Llamero/MHz_LED_Modulator/2.png

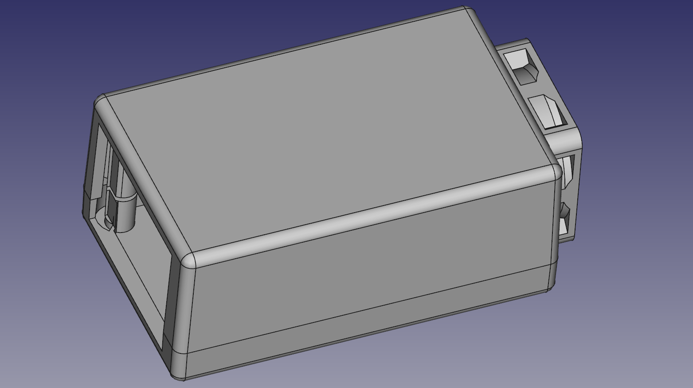
2.png
