Llamero/MHz_LED_Modulator/1.PNG

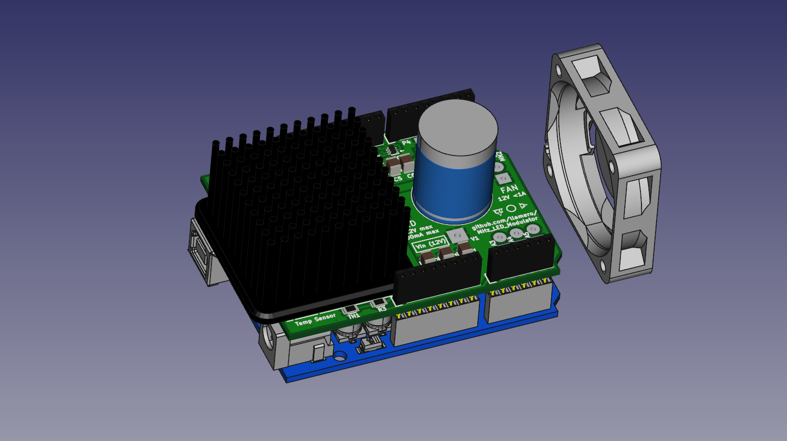
1.PNG
