Llamero/MHz_LED_Modulator/3.png

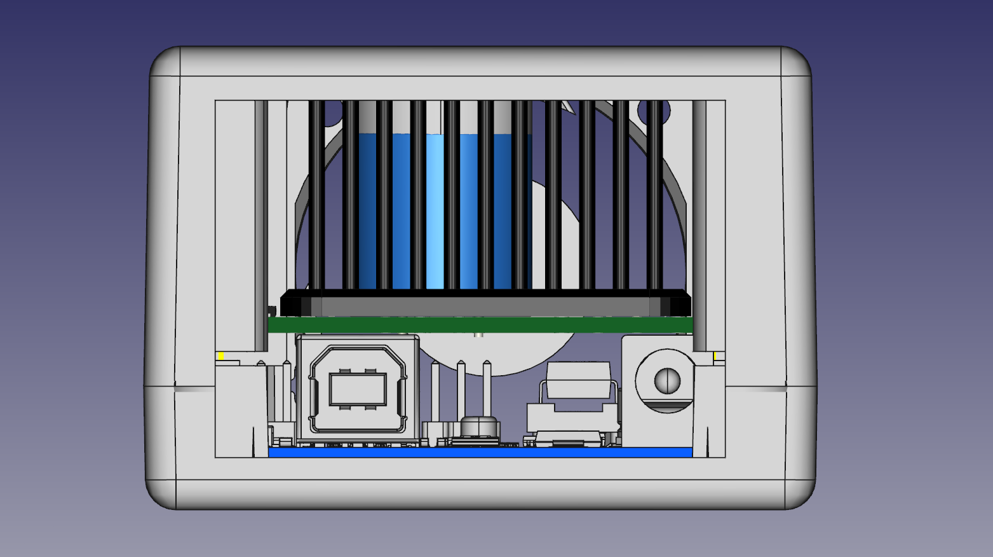
3.png
