Llamero/MHz_LED_Modulator/MHz_LED_Modulator.png

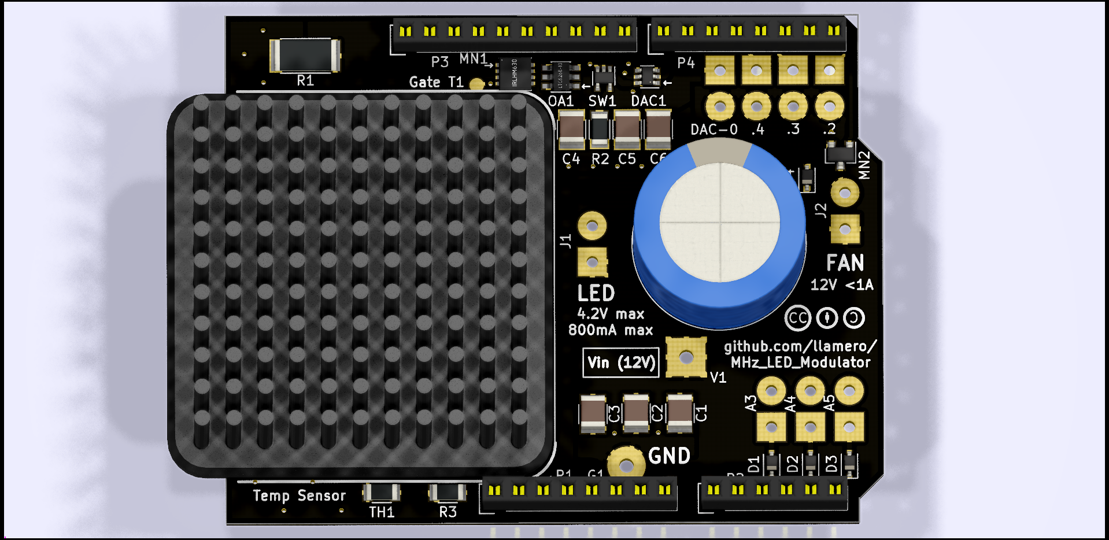
MHz_LED_Modulator.png
