Llamero/MHz_LED_Modulator/OPAmp to MOSFET test - draft 7c - best setup -stable - PCB impedance included.asc

C1: cap; 0.22µ; V=100 Irms=2.1 Rser=0.0606238 Lser=0
C2: cap; 1µ; V=100 Irms=5.63 Rser=0.0203188 Lser=0 mfg="KEMET" pn="C1210C105K1RAC" type="X7R"
C3: cap; 100p
C4: cap; 5.2p
C5: cap; 10µ; V=35 Irms=8.06 Rser=0.00577565 Lser=0 mfg="KEMET" pn="C1210C106K6PAC" type="X5R"
C6: polcap; 100µ; V=16 Irms=2.65653 Rser=0.035 Lser=0
C7: polcap; 4700µ; V=35 Irms=2.03 Rser=0.033 Lser=0 mfg="Nichicon" pn="UPR1V472MRH" type="Al electrolytic"
C8: cap; 5.2p
C9: cap; 5.2p
C10: cap; 0.22µ; V=100 Irms=2.1 Rser=0.0606238 Lser=0
D1: LED; LXK2-PW14
D2: schottky; RBR2L60A
L1: ind; 100µ
L2: ind; 100µ
L3: ind; 1n
L4: ind; 52.5n
L5: ind; 14n
L6: ind; 52.5n
L7: ind; 52.5n
M1: nmos; IRLHM630
M2: nmos; IRLHM630
R1: res; 4.7; tol=1 pwr=16
R2: res; 5k
R3: res; 1
R4: res; 28.8m
R5: res; 18.8m
R6: res; 18.8m
R7: res; 10m
U1: LTC6268-10
V1: voltage; 0.01; Rser=1
V2: voltage; 5; Rser=1
V3: voltage; PULSE(0 5 50n 10n 10n 2u 4u); Rser=1
V4: voltage; 12; Rser=0.1
Named nets: 0
.model IRL510 VDMOS(Rg=3 Vto=1.9 Rd=200m Rs=155m Rb=40m lambda=.01 Kp=1.9 Cgdmax=.7n Cgdmin=.01n Cgs=.25n Cjo=.17n Is=17p ksubthres=.1 mfg=International_Rectifier Vds=100 Ron=540m Qg=8.3n)
.tran 0 8u 0 50p
https://www.digikey.com/product-detail/en/susumu/CPA2512Q4R70FS-T10/408-1661-2-ND/1935788
Cat5e ethernet cable - 3x10cm blocks
.model S1 SW(Ron=10 Roff=10Meg Vt=2.5 Vh=0.3
