Llamero/MHz_LED_Modulator/KiCAD files/MHz_LED_Modulator.kicad_pcb

## KiCad design KiCAD files/MHz_LED_Modulator.kicad_pcb (2017-12-07)

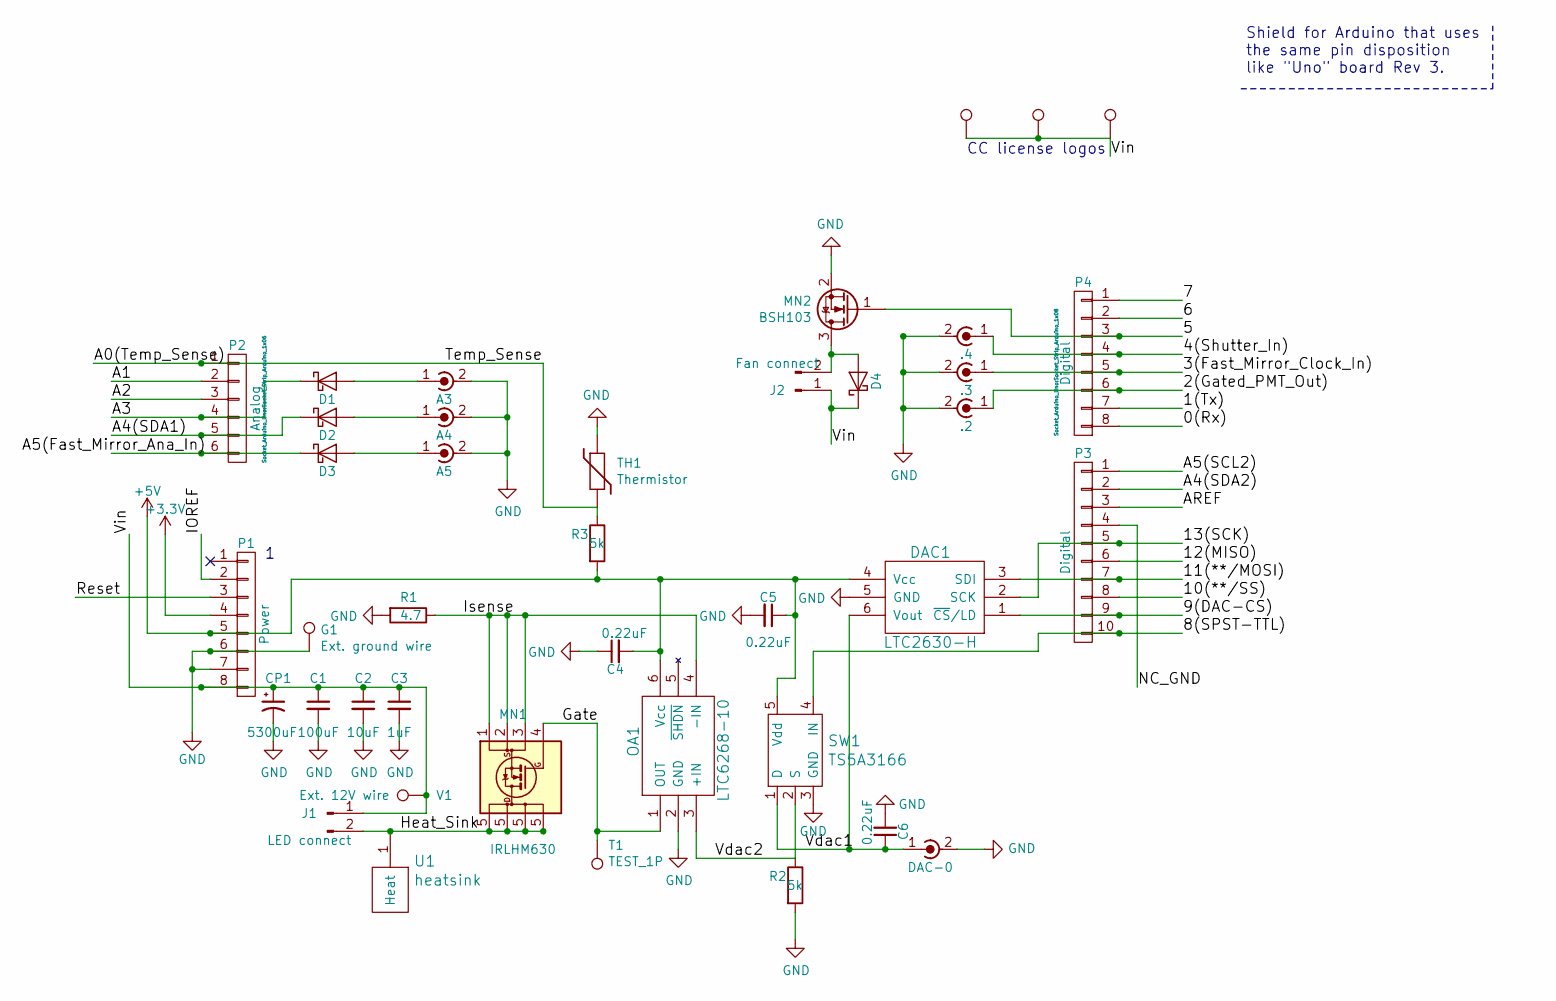
[picture p5: schematic MHz_LED_Modulator.sch]

Parts:
.2, .3, .4: Conn_Coaxial_Power; SolderWirePad_2x_1-2mmDrill-BNC; Manufacturer Part # BU-P4969; Digikey Part # 314-1190-ND
A3, A4, A5: Conn_Coaxial_Power; SolderWirePad_2x_1-2mmDrill-BNC; Manufacturer Part # BU-P4969; Digikey Part # 314-1190-ND
C1: 100uF; C_1210; Manufacturer Part # CC1210MKX5R7BB107; Digikey Part # 311-2052-1-ND
C2: 10uF; C_1210; Manufacturer Part # EMK325BJ106KN-T; Digikey Part # 587-1376-1-ND
C3: 1uF; C_1210; Manufacturer Part # UMK325B7105KH-T; Digikey Part # 587-1366-1-ND
C4, C5, C6: 0.22uF; C_1210; Manufacturer Part # HMK325B7224KN-T; Digikey Part # 587-1363-1-ND
CP1: 5300uF; CP_Radial_D18.0mm_P7.50mm; Manufacturer Part # ELBK250ELL532AM20S; Digikey Part # 565-4338-ND
D1, D2, D3, D4: D_Schottky; D_SOD-323; Manufacturer Part # CUS10S30,H3F; Digikey Part # CUS10S30H3FCT-ND
DAC1: LTC2630-H; SOT-363_SC-70-6; Manufacturer Part # LTC2630ACSC6-HZ12#TRMPBF; Digikey Part # LTC2630ACSC6-HZ12#TRMPBFCT-ND
DAC-0: Conn_Coaxial_Power; SolderWirePad_2x_1-2mmDrill-BNC; Manufacturer Part # BU-P4969; Digikey Part # 314-1190-ND
G1: Ext. ground wire; SolderWirePad_single_1-5mmDrill
J1: LED connect; SolderWirePad_2x_1-2mmDrill-BNC; Manufacturer Part # 909; Digikey Part # 1528-1572-ND
J2: Fan connect; SolderWirePad_2x_1-2mmDrill-BNC; Manufacturer Part # AFB0412VHA-A; Digikey Part # 603-1898-ND
J3: TEST_1P; CC_silkscreen; Manufacturer Part # A000066; Digikey Part # 1050-1024-ND
J4: TEST_1P; CC_Attribution; Manufacturer Part # 1594CBK; Digikey Part # HM228-ND
J5: TEST_1P; CC_Share_alike; Manufacturer Part # DK-1511-001/BL; Digikey Part # AE10476-ND
MN1: IRLHM630; Manufacturer Part # IRLHM630TRPBF; Digikey Part # IRLHM630TRPBFCT-ND
MN2: BSH103; SOT-23; Manufacturer Part # BSH103,235; Digikey Part # 1727-1883-1-ND
OA1: LTC6268-10; LTC6268IS6-10-TR; Manufacturer Part # LTC6268IS6-10#TRMPBF; Digikey Part # LTC6268IS6-10#TRMPBFCT-ND
P1: Power; Socket_Strip_Arduino_1x08
P2: Analog; Socket_Strip_Arduino_1x06
P3: Digital; Socket_Strip_Arduino_1x10; Manufacturer Part # 85; Digikey Part # 1528-1074-ND
P4: Digital; Socket_Strip_Arduino_1x08
R1: 4.7; R_2512; Manufacturer Part # CPA2512Q4R70FS-T10; Digikey Part # 408-1661-1-ND
R2, R3: 5k; R_1206; Manufacturer Part # RT1206BRD075KL; Digikey Part # YAG5090CT-ND
SW1: TS5A3166; SOT-353_SC-70-5; Manufacturer Part # TS5A3166DCKR; Digikey Part # 296-17741-1-ND
T1: TEST_1P; Measurement_Point_Round-SMD-Pad_Small
TH1: Thermistor; R_1206; Manufacturer Part # NC20K00103KBA; Digikey Part # 478-10982-1-ND
U1: heatsink; 40x40mm-heatsink_only-half-pad; Manufacturer Part # 910-40-2-23-2-B-0; Digikey Part # 345-1161-ND
V1: Ext. 12V wire; SolderWirePad_single_1-5mmDrill-square; Manufacturer Part # SDI40-12-UC-P5; Digikey Part # 102-4112-ND

Connections:
+3V3: P1.4
+5V: C4.2, C5.1, DAC1.4 (Vcc), OA1.6 (Vcc), P1.5, R3.2, SW1.5 (Vdd)
/0(Rx): P4.8
/1(Tx): P4.7
/2(Gated_PMT_Out): .2.1 (In), P4.6
/3(Fast_Mirror_Clock_In): .3.1 (In), P4.5
/4(Shutter_In): .4.1 (In), P4.4
/5: MN2.1 (G), P4.3
/6: P4.2
/7: P4.1
/8(SPST-TTL): P3.10, SW1.4 (IN)
/9(DAC-CS): DAC1.1 (~CS~/LD), P3.9
/10(**/SS): P3.8
/11(**/MOSI): DAC1.3 (SDI), P3.7
/12(MISO): P3.6
/13(SCK): DAC1.2 (SCK), P3.5
/A0(Temp_Sense): P2.1, R3.1, TH1.2
/A1: P2.2
/A2: P2.3
/A3: D1.1 (K), P2.4
/A4(SDA1): D2.1 (K), P2.5
/A4(SDA2): P3.2
/A5(SCL2): P3.1
/AREF: P3.3
/Gate: MN1.4 (G), OA1.1 (OUT), T1.1
/Heat_Sink: J1.2, MN1.5 (D), U1.1
/IOREF: P1.2
/Isense: MN1.1 (S), MN1.2 (S), MN1.3 (S), OA1.4 (-IN), R1.1
/NC_GND: P3.4
/Reset: P1.3
/Vdac1: C6.1, DAC1.6 (Vout), DAC-0.1 (In), SW1.1 (D)
/Vdac2: OA1.3 (+IN), R2.1, SW1.2 (S)
/Vin: C1.1, C2.1, C3.1, CP1.1, D4.1 (K), J1.1, J2.1, J3.1, J4.1, J5.1, P1.8, V1.1
GND: .2.2 (Ext), .3.2 (Ext), .4.2 (Ext), A3.2 (Ext), A4.2 (Ext), A5.2 (Ext), C1.2, C2.2, C3.2, C4.1, C5.2, C6.2, CP1.2, DAC1.5 (GND), DAC-0.2 (Ext), G1.1, MN2.2 (S), OA1.2 (GND), P1.6, P1.7, R1.2, R2.2, SW1.3 (GND), TH1.1
unnamed: A3.1 (In), D1.2 (A)
unnamed: A4.1 (In), D2.2 (A)
unnamed: A5.1 (In), D3.2 (A)
unnamed: D3.1 (K), P2.6
unnamed: D4.2 (A), J2.2, MN2.3 (D)

Notes on the sheet:
Shield for Arduino that uses the same pin disposition like "Uno" board Rev 3.
CC license logos

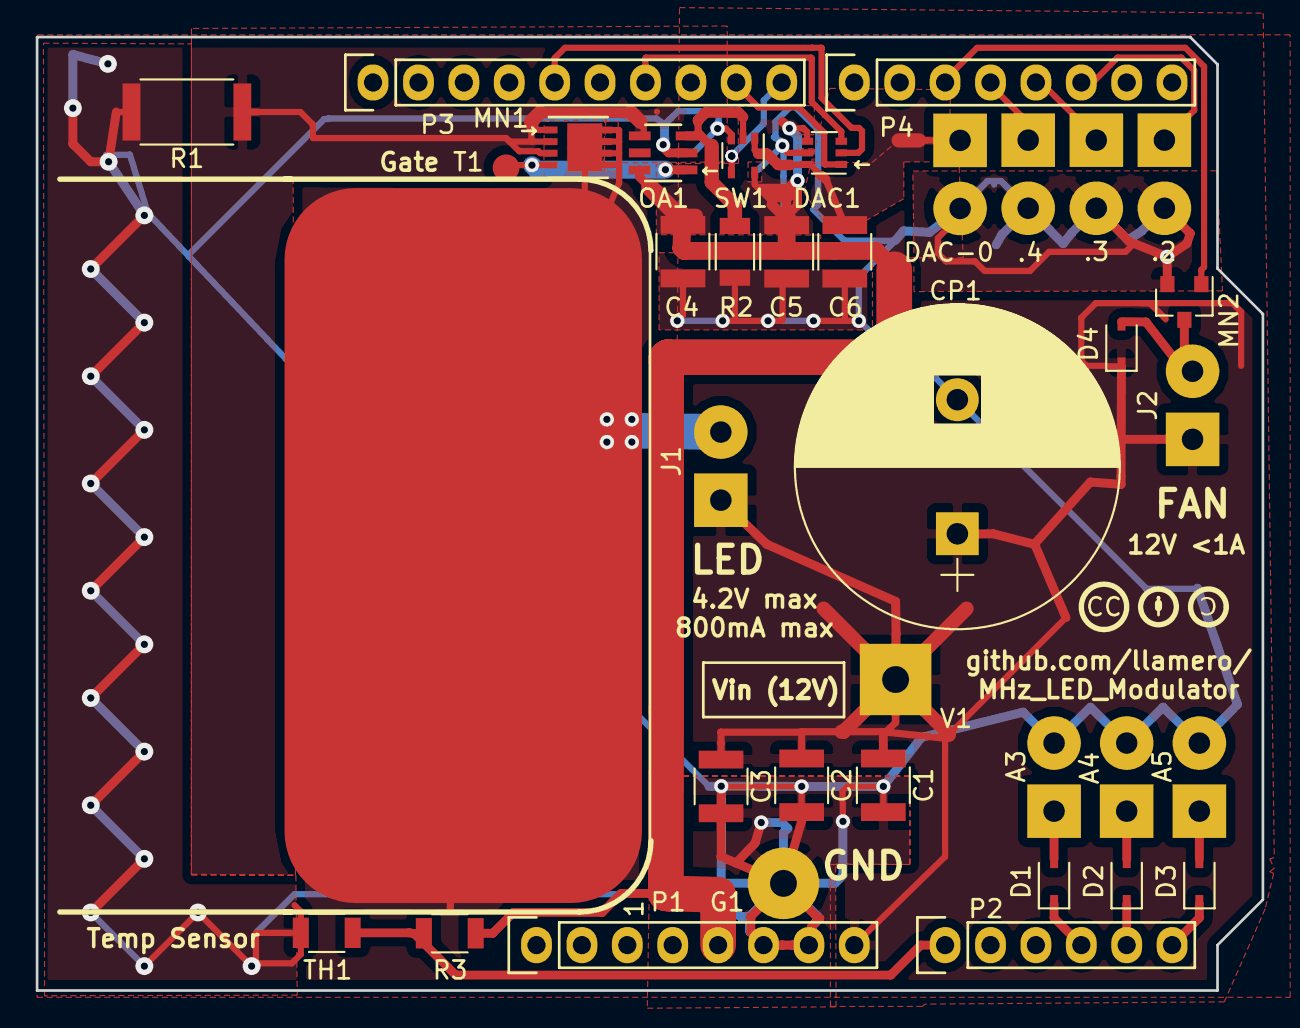
[picture p6: board MHz_LED_Modulator.kicad_pcb from above]

Board: 2 copper layers, 68.6 x 53.3 mm, 40 parts (0 on the bottom side), 24 nets.
