Llamero/MHz_LED_Modulator/(commit log)

2017-12-07 Inital upload
    Upload of version submitted for manufacturing
    [MHz_LED_Modulator-B.Cu.gbl, MHz_LED_Modulator-B.Mask.gbs, MHz_LED_Modulator-B.Paste.gbp, MHz_LED_Modulator-B.SilkS.gbo, MHz_LED_Modulator-Edge.Cuts.gm1, MHz_LED_Modulator-F.Cu.gtl, MHz_LED_Modulator-F.Mask.gts, MHz_LED_Modulator-F.Paste.gtp]
2017-12-07 Add design images
    Add design images to show assembly
